Sarahhan-one/tiny85_watch/pcb/2D_PCB_back.png

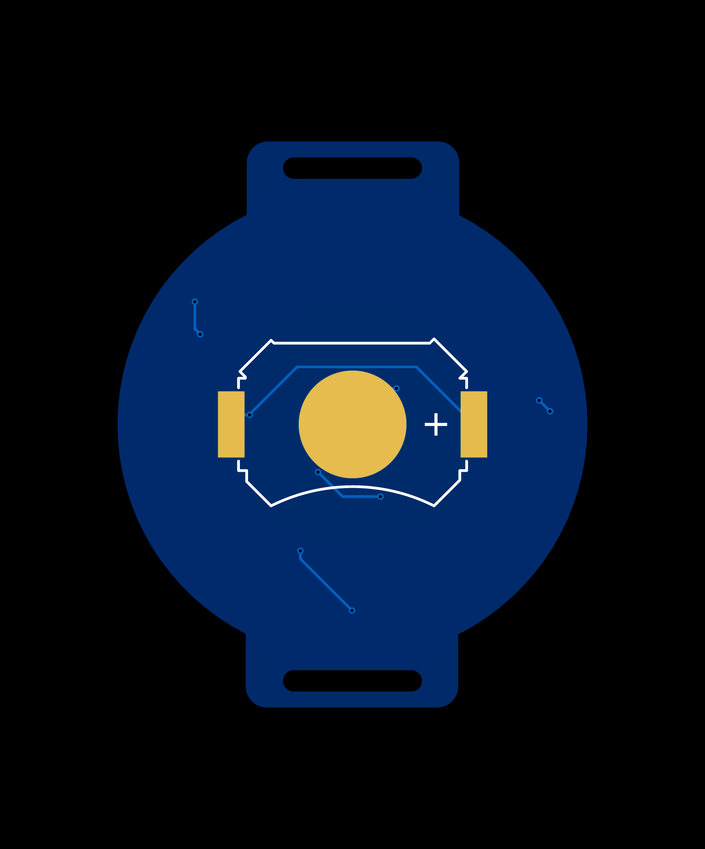
pcb/2D_PCB_back.png
