Sarahhan-one/tiny85_watch/pcb/2D_PCB_front.png

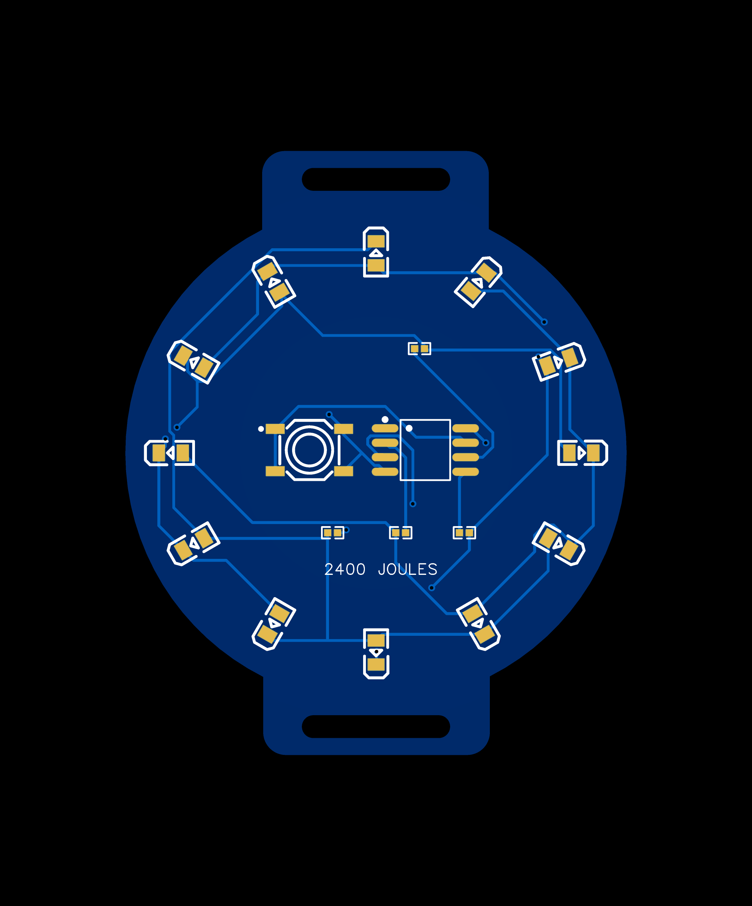
pcb/2D_PCB_front.png
