Sarahhan-one/tiny85_watch/pcb/3D_PCB.png

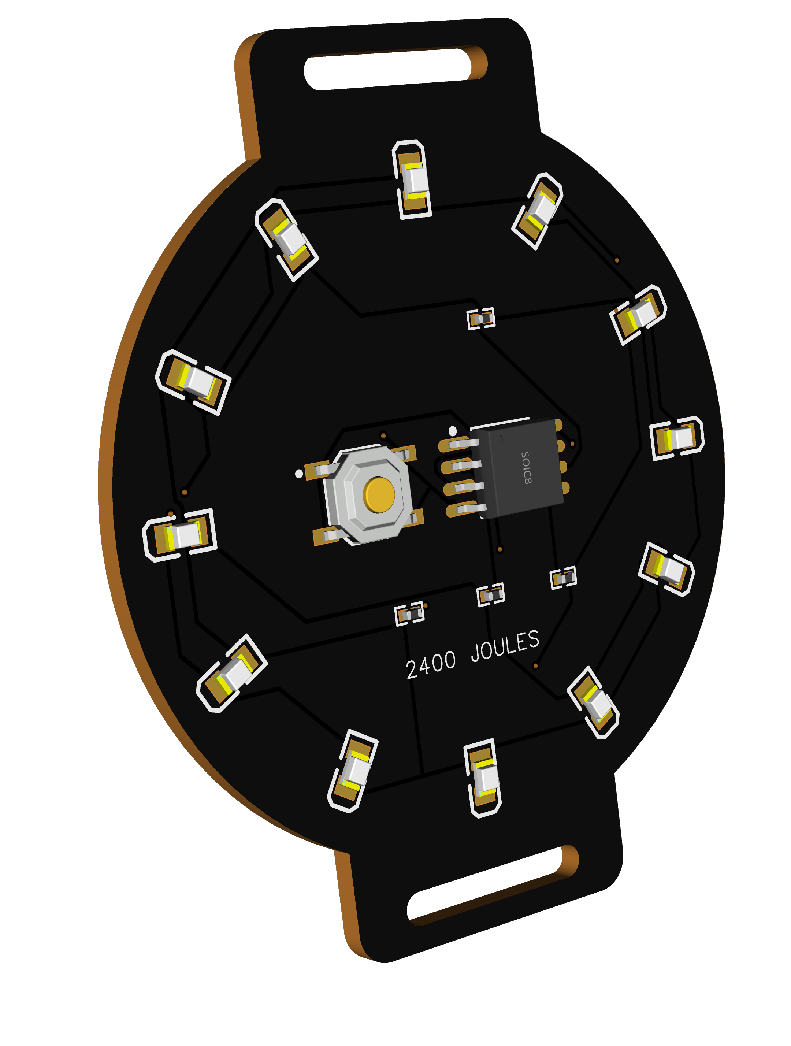
pcb/3D_PCB.png
