Sarahhan-one/tiny85_watch/Schematic_tinywatch.pdf

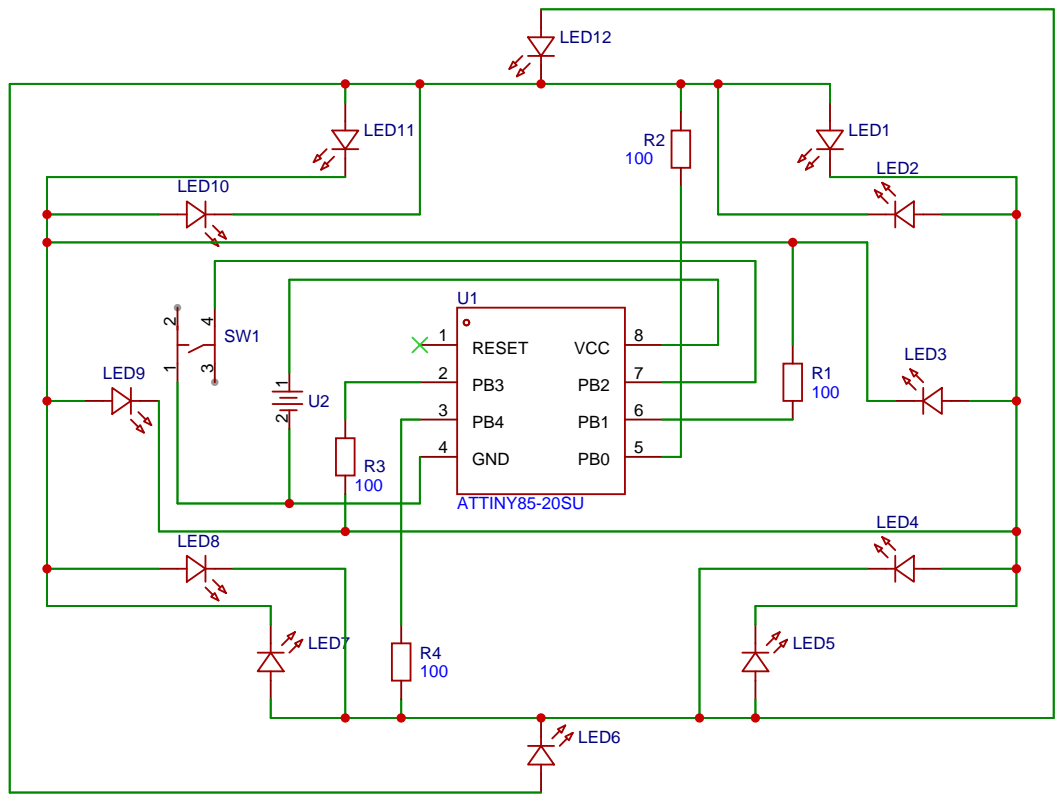
[picture p4: page 1]
