Sarahhan-one/tiny85_watch/(commit log)

2024-11-05 modify the behavior when hours and minutes LEDs overlap
2024-11-06 add pcb images
2024-11-28 fix schematic and code
    [tiny85_watch.ino]
